worldwideweasel/G.N.O.S.I.S.-General-Operator/docs/img/gnosis_panel_02.jpeg

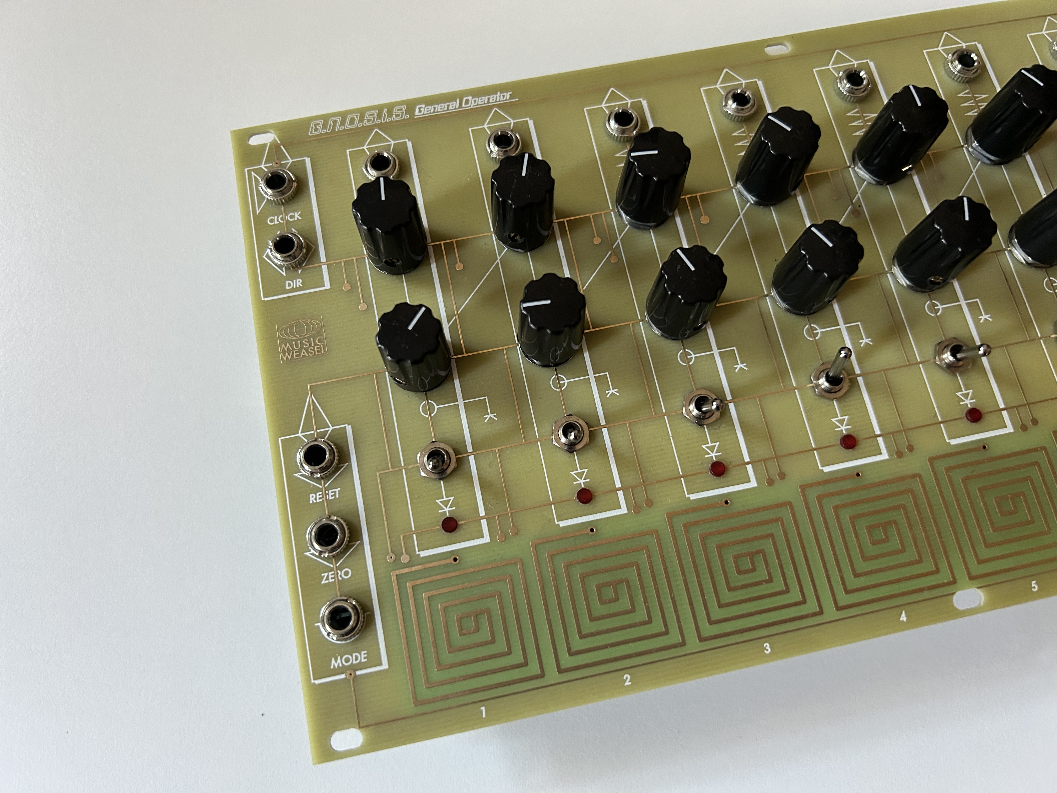
docs/img/gnosis_panel_02.jpeg
