worldwideweasel/G.N.O.S.I.S.-General-Operator/docs/img/gnosis_pcb_04.jpeg

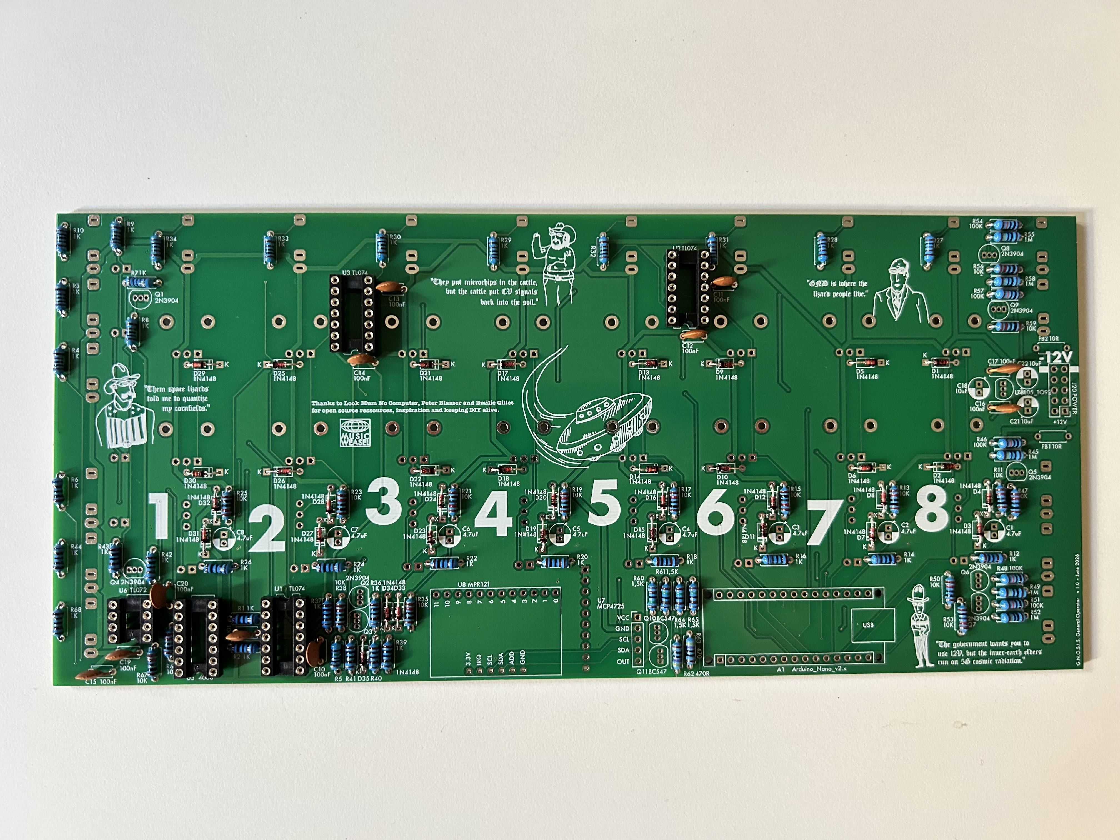
docs/img/gnosis_pcb_04.jpeg
