worldwideweasel/G.N.O.S.I.S.-General-Operator/docs/img/gnosis_pcb_11.jpeg

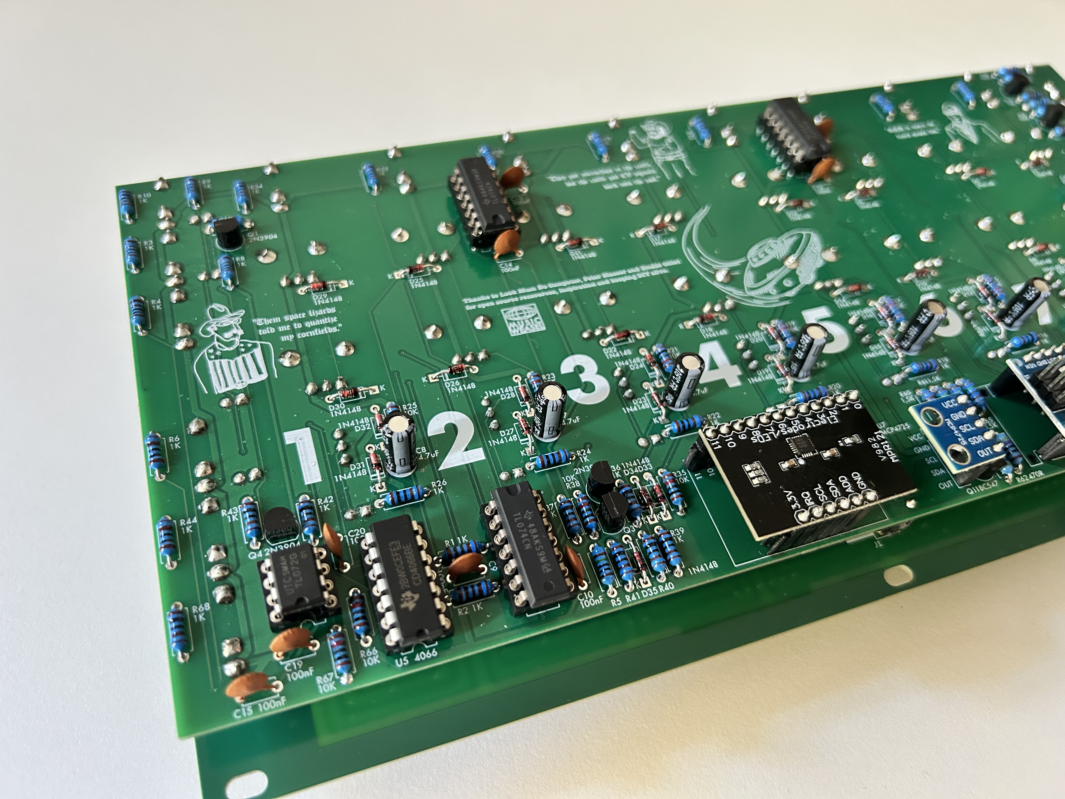
docs/img/gnosis_pcb_11.jpeg
