worldwideweasel/G.N.O.S.I.S.-General-Operator/docs/img/gnosis_pcb_13.jpeg

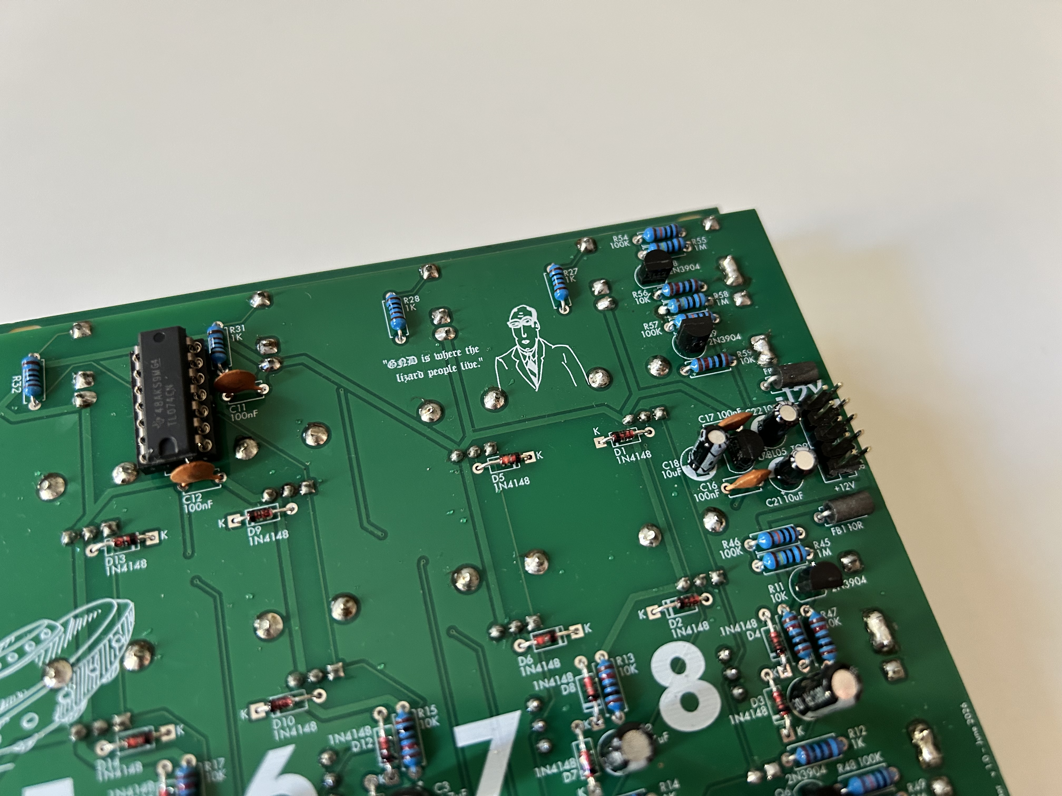
docs/img/gnosis_pcb_13.jpeg
