worldwideweasel/G.N.O.S.I.S.-General-Operator/docs/img/gnosis_pcb_15.jpeg

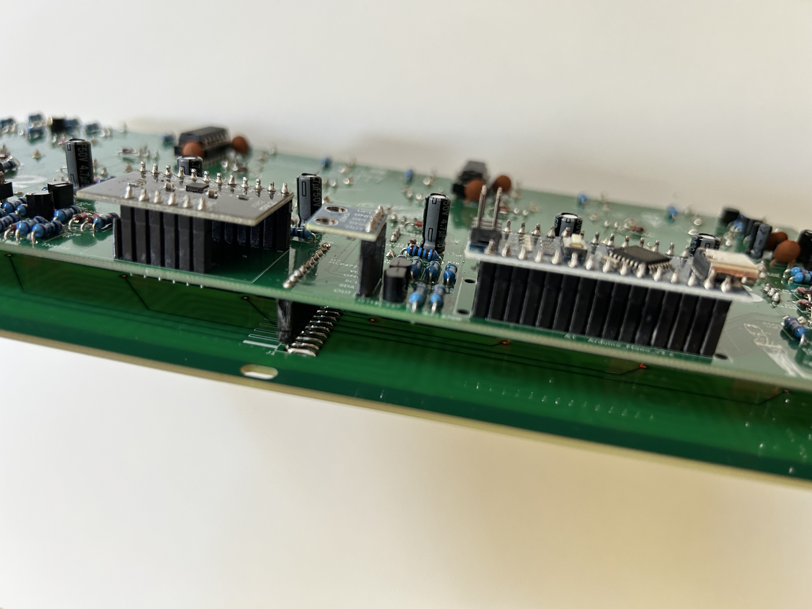
docs/img/gnosis_pcb_15.jpeg
