worldwideweasel/G.N.O.S.I.S.-General-Operator/src/GNOSIS_v2.1_board.pdf

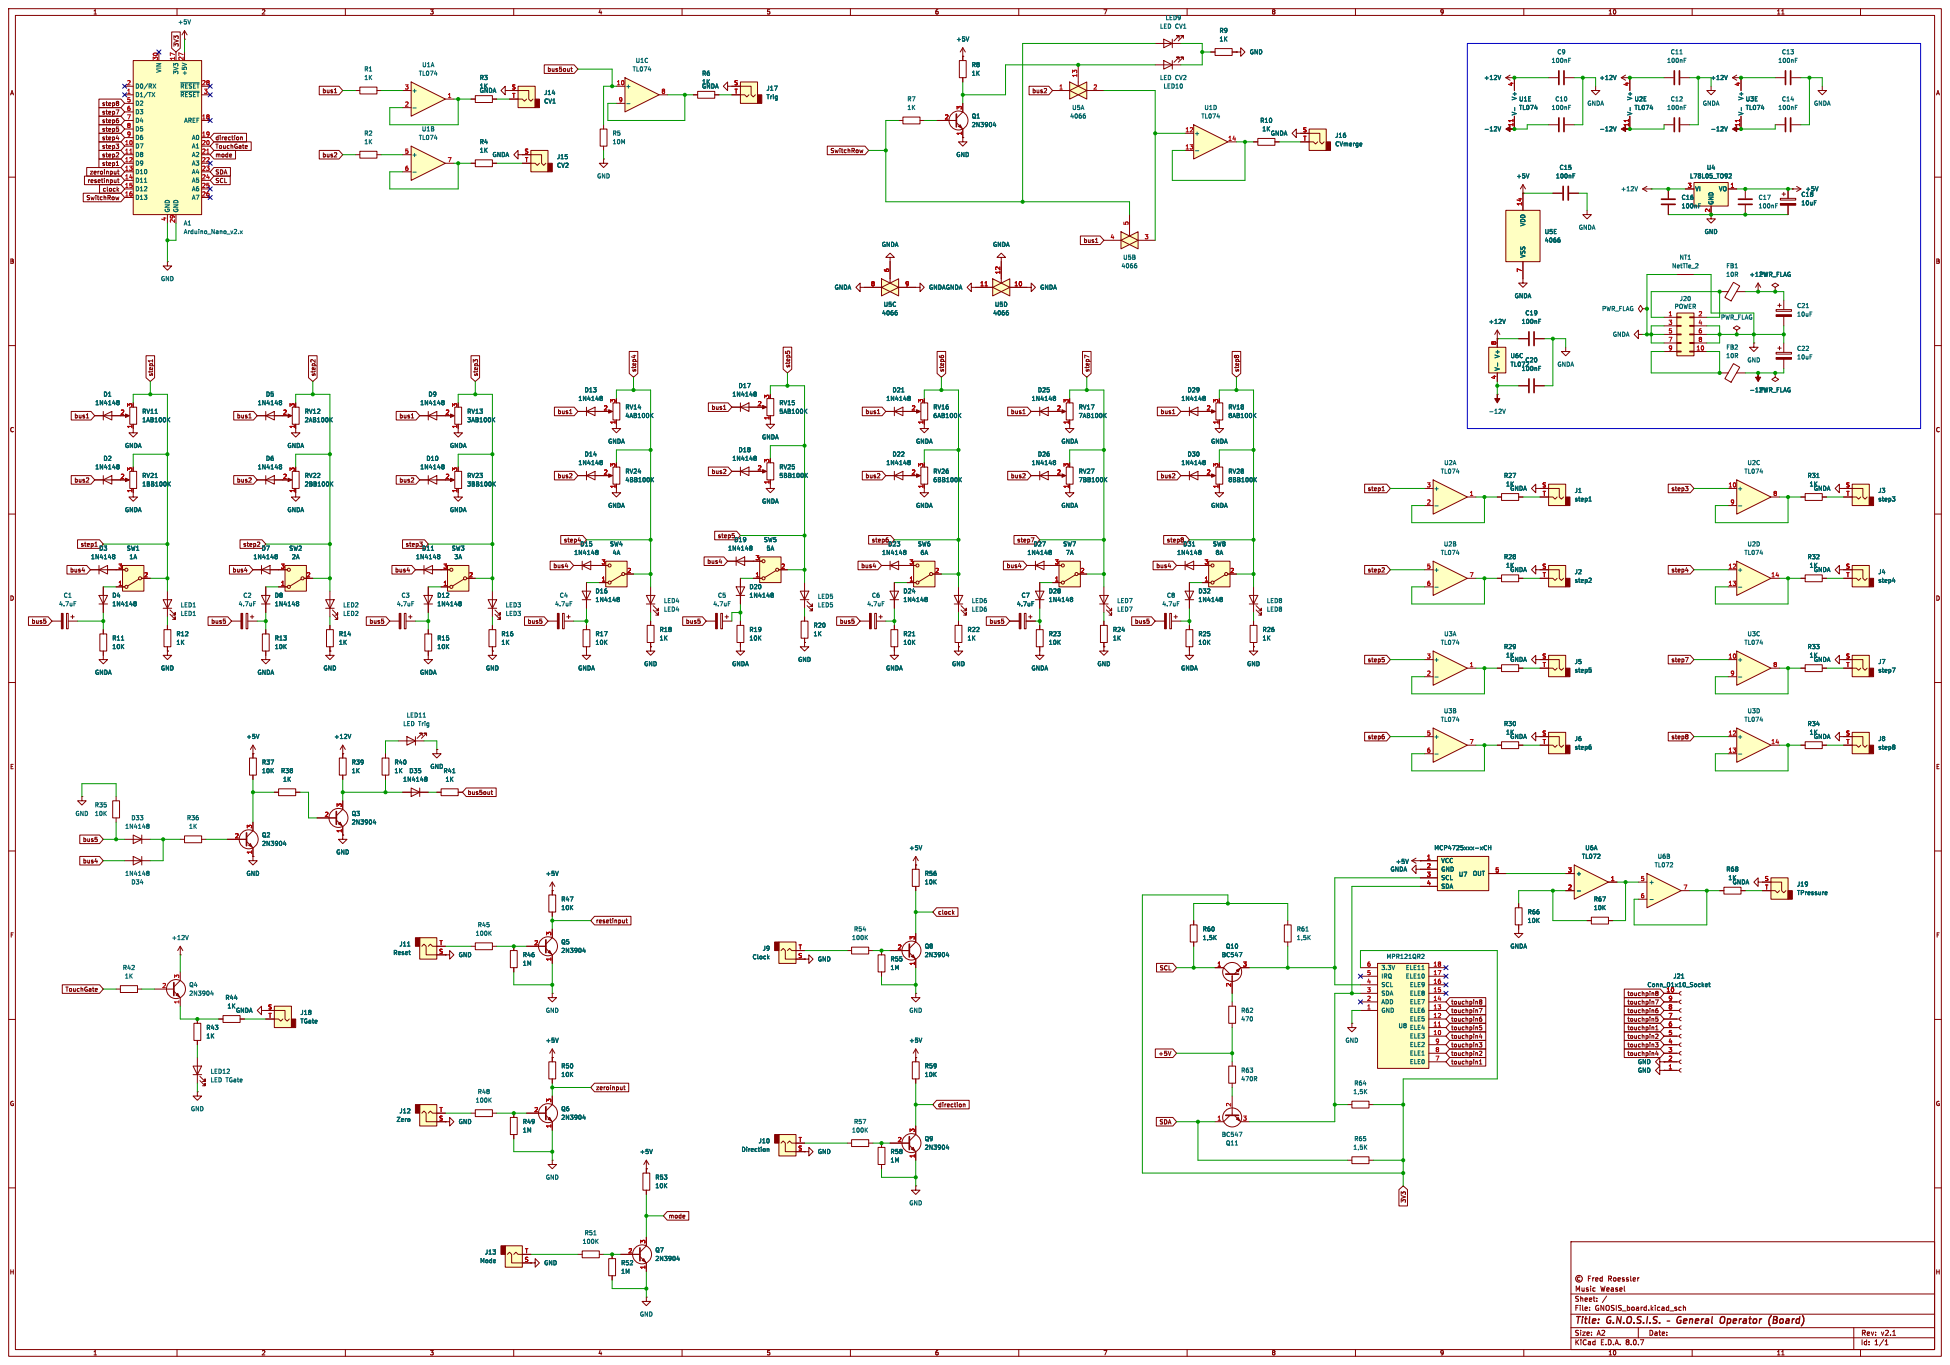
[picture p19: page 1]
