worldwideweasel/G.N.O.S.I.S.-General-Operator/src/GNOSIS_v2.1_panel.pdf

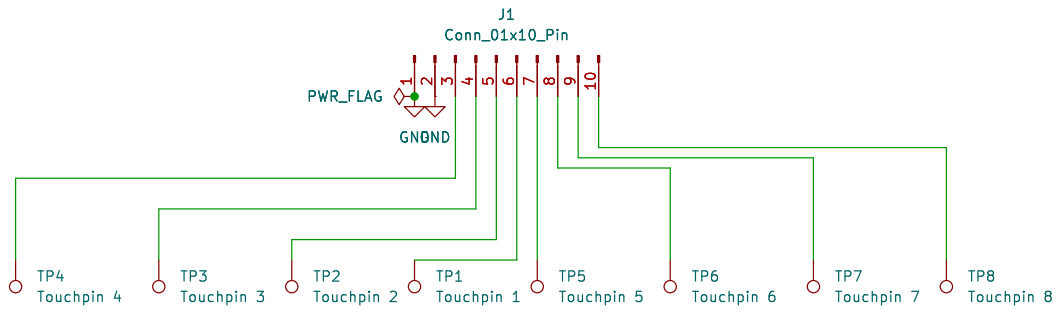
[picture p20: page 1]
